lamdat1509/IOT-Lora_mesh-Graduation-Project/CODE/Website/assest/img/sang1.png

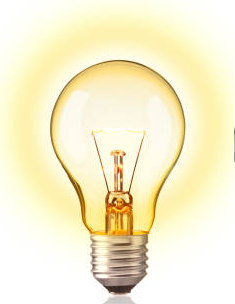
CODE/Website/assest/img/sang1.png
