lamdat1509/IOT-Lora_mesh-Graduation-Project/Circuit_design_IOT_Node/Documents_Circuit_design/3.3v AMS.jpg

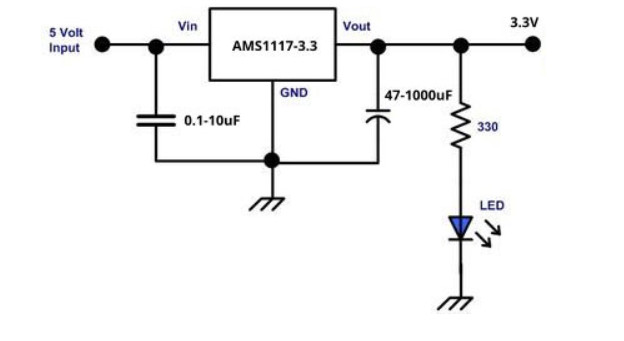
Circuit_design_IOT_Node/Documents_Circuit_design/3.3v AMS.jpg
