lamdat1509/IOT-Lora_mesh-Graduation-Project/Circuit_design_IOT_Node/Documents_Circuit_design/lm2596.jpg

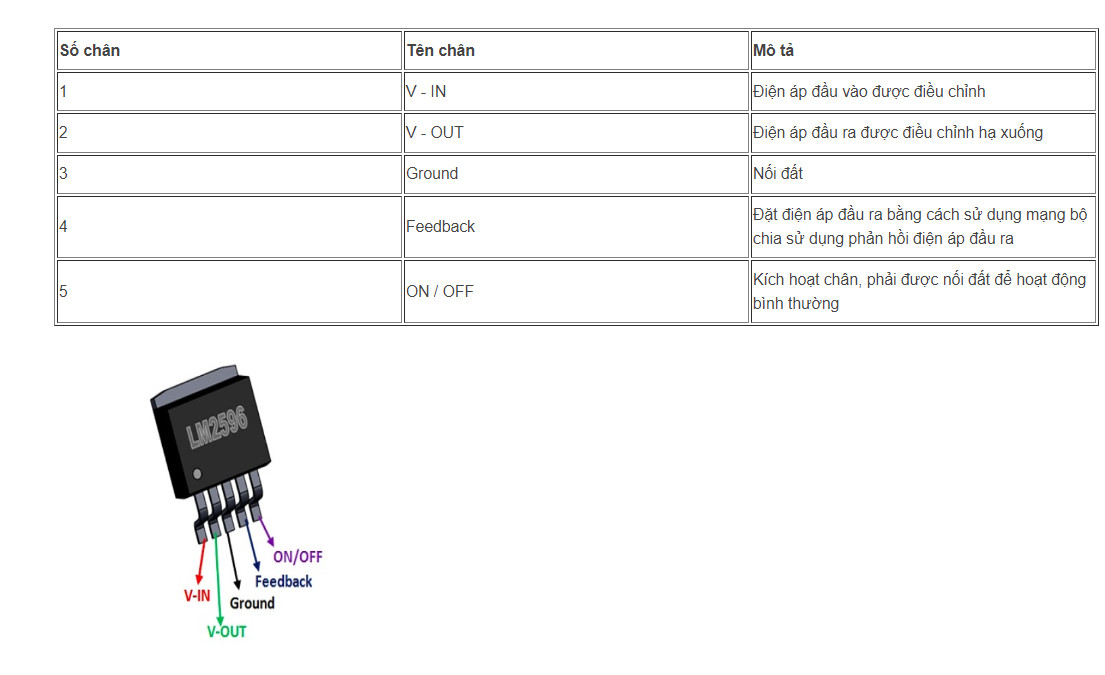
Circuit_design_IOT_Node/Documents_Circuit_design/lm2596.jpg
