lamdat1509/IOT-Lora_mesh-Graduation-Project/CODE/Website/assest/img/toi.png

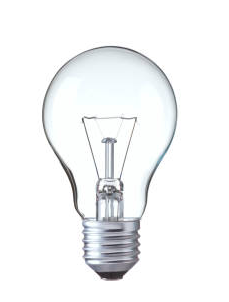
CODE/Website/assest/img/toi.png
