lamdat1509/IOT-Lora_mesh-Graduation-Project/(list of files, drawings)

Other design files:
Circuit_design_IOT_Node/nguyenly.schdoc
Circuit_design_IOT_Node/PCB_main.pcbdoc
Circuit_design_IOT_Node/PCB_MAX_QUANG.pcbdoc
Circuit_design_IOT_Node/SCH_MAX31865.SchDoc
