lamdat1509/IOT-Lora_mesh-Graduation-Project/CODE/IOT_3_NODE/Node1_NhietDo/Core/Src/main.c

	/* USER CODE BEGIN Header */
/**
  ******************************************************************************
  * @file           : main.c
  * @brief          : Main program body
  ******************************************************************************
  * @attention
  *
  * Copyright (c) 2023 STMicroelectronics.
  * All rights reserved.
  *
  * This software is licensed under terms that can be found in the LICENSE file
  * in the root directory of this software component.
  * If no LICENSE file comes with this software, it is provided AS-IS.
  *
  ******************************************************************************
  */
/* USER CODE END Header */
/* Includes ------------------------------------------------------------------*/
#include "main.h"

/* USER CODE BEGIN Includes */
#include "MAX31865_lib.h"
#include <stdio.h>
#include <stdbool.h>
#include <string.h>
#include <math.h>
float PT100_Temperature = 0.0f;
/* USER CODE END Includes */

 ADC_HandleTypeDef hadc1;

SPI_HandleTypeDef hspi1;

UART_HandleTypeDef huart1;

void SystemClock_Config(void);
static void MX_GPIO_Init(void);
static void MX_SPI1_Init(void);
static void MX_USART1_UART_Init(void);
static void MX_ADC1_Init(void);
/* USER CODE BEGIN 0 */
uint16_t analog;
char charToTransmit[15];
char receive[15];
/* USER CODE END 0 */

/**
  * @brief  The application entry point.
  * @retval int
  */
int main(void)
{
  /* MCU Configuration--------------------------------------------------------*/

  /* Reset of all peripherals, Initializes the Flash interface and the Systick. */
  HAL_Init();

  /* Configure the system clock */
  SystemClock_Config();

  /* Initialize all configured peripherals */
  MX_GPIO_Init();
  MX_SPI1_Init();
  MX_USART1_UART_Init();
  MX_ADC1_Init();
  /* USER CODE BEGIN 2 */
  MAX31865_Init(3);
  HAL_UART_Receive_IT(&huart1,receive,1);
  /* USER CODE END 2 */

  /* Infinite loop */
  /* USER CODE BEGIN WHILE */
  while (1)
  {
    /* USER CODE END WHILE */

    /* USER CODE BEGIN 3 */
	PT100_Temperature = MAX31865_Get_Temperature();
	if (PT100_Temperature >= 0) {
		PT100_Temperature = PT100_Temperature + 0.05;
		snprintf(charToTransmit,sizeof(charToTransmit),"1_4_%.0f ",PT100_Temperature);
		HAL_UART_Transmit(&huart1,charToTransmit,strlen(charToTransmit),100);
	}
	else {
		//PT100_Temperature = MAX31865_Get_Temperature() - 0.05;
		PT100_Temperature = -PT100_Temperature + 0.05;
		snprintf(charToTransmit,sizeof(charToTransmit),"1_4_%.0f ",PT100_Temperature);
		HAL_UART_Transmit(&huart1,charToTransmit,strlen(charToTransmit),100);
	}


	HAL_Delay(8000);


  }
  /* USER CODE END 3 */
}

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
